asukiaaa/SideBBForRaspberryPi/plate/plate_for_raspi_pins.FCStd

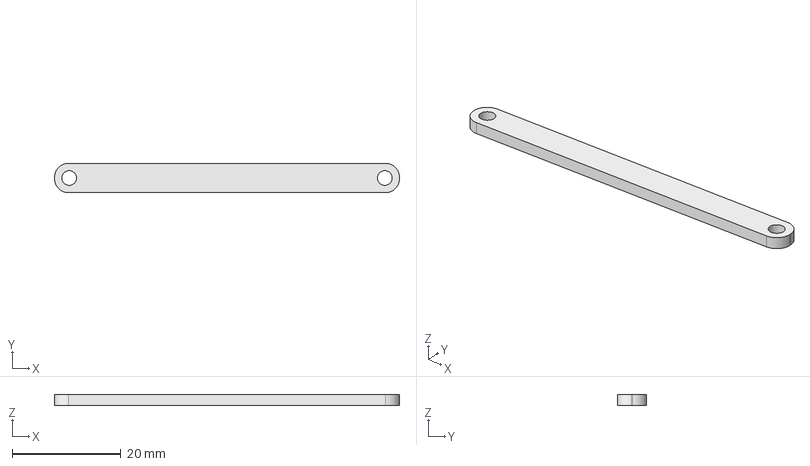
[picture p2: CAD file, 2023-03-24]
plate/plate_for_raspi_pins.FCStd
63.4 x 5.40 x 2.00 mm
