asukiaaa/SideBBForRaspberryPi/main_pcb/main_pcb.kicad_pcb

## KiCad design main_pcb/main_pcb.kicad_pcb (2020-06-21)

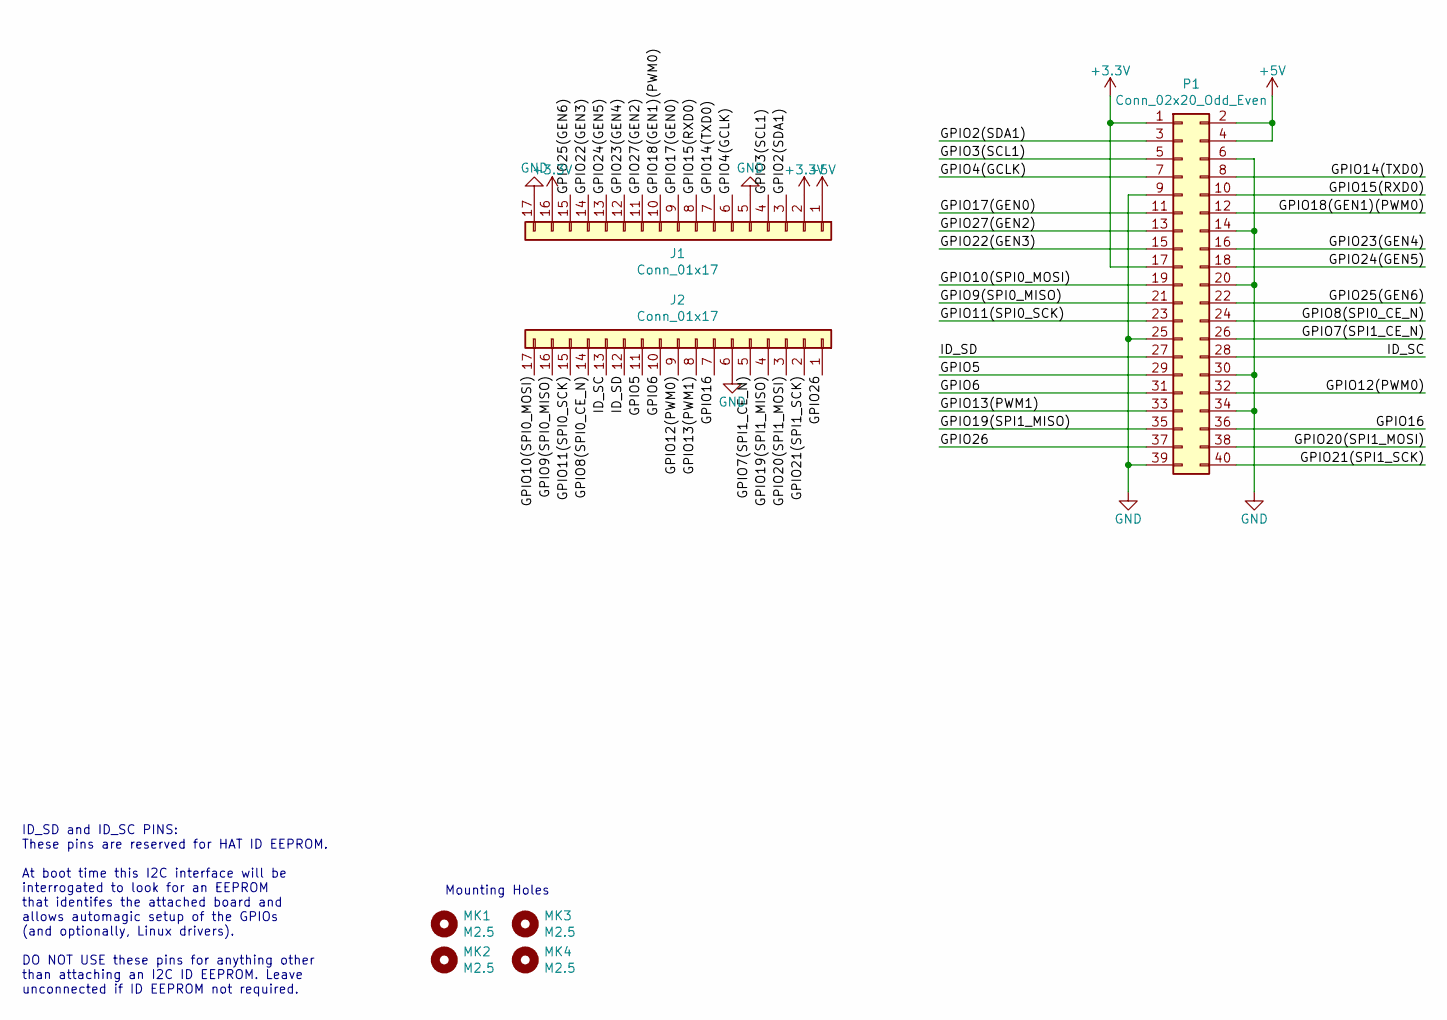
[picture p6: schematic main_pcb.sch]

Parts:
J1, J2: Conn_01x17; PinSocket_1x17_P2.54mm_Vertical
MK1, MK2, MK3, MK4: M2.5; MountingHole_2.7mm_M2.5
P1: Conn_02x20_Odd_Even; PinHeader_2x20_P2.54mm_Vertical

Connections:
+3V3: J1.2, J1.16, P1.1, P1.17
+5V: J1.1, P1.2, P1.4
/GPIO2(SDA1): J1.3, P1.3
/GPIO3(SCL1): J1.4, P1.5
/GPIO4(GCLK): J1.6, P1.7
/GPIO5: J2.11, P1.29
/GPIO6: J2.10, P1.31
/GPIO7(SPI1_CE_N): J2.5, P1.26
/GPIO8(SPI0_CE_N): J2.14, P1.24
/GPIO9(SPI0_MISO): J2.16, P1.21
/GPIO10(SPI0_MOSI): J2.17, P1.19
/GPIO11(SPI0_SCK): J2.15, P1.23
/GPIO12(PWM0): J2.9, P1.32
/GPIO13(PWM1): J2.8, P1.33
/GPIO14(TXD0): J1.7, P1.8
/GPIO15(RXD0): J1.8, P1.10
/GPIO16: J2.7, P1.36
/GPIO17(GEN0): J1.9, P1.11
/GPIO18(GEN1)(PWM0): J1.10, P1.12
/GPIO19(SPI1_MISO): J2.4, P1.35
/GPIO20(SPI1_MOSI): J2.3, P1.38
/GPIO21(SPI1_SCK): J2.2, P1.40
/GPIO22(GEN3): J1.14, P1.15
/GPIO23(GEN4): J1.12, P1.16
/GPIO24(GEN5): J1.13, P1.18
/GPIO25(GEN6): J1.15, P1.22
/GPIO26: J2.1, P1.37
/GPIO27(GEN2): J1.11, P1.13
/ID_SC: J2.13, P1.28
/ID_SD: J2.12, P1.27
GND: J1.5, J1.17, J2.6, P1.6, P1.9, P1.14, P1.20, P1.25, P1.30, P1.34, P1.39

Notes on the sheet:
ID_SD and ID_SC PINS: These pins are reserved for HAT ID EEPROM. At boot time this I2C interface will be interrogated to look for an EEPROM that identifes the attached board and allows automagic setup of the GPIOs (and optionally, Linux drivers). DO NOT USE these pins for anything other than attach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
Mounting Holes

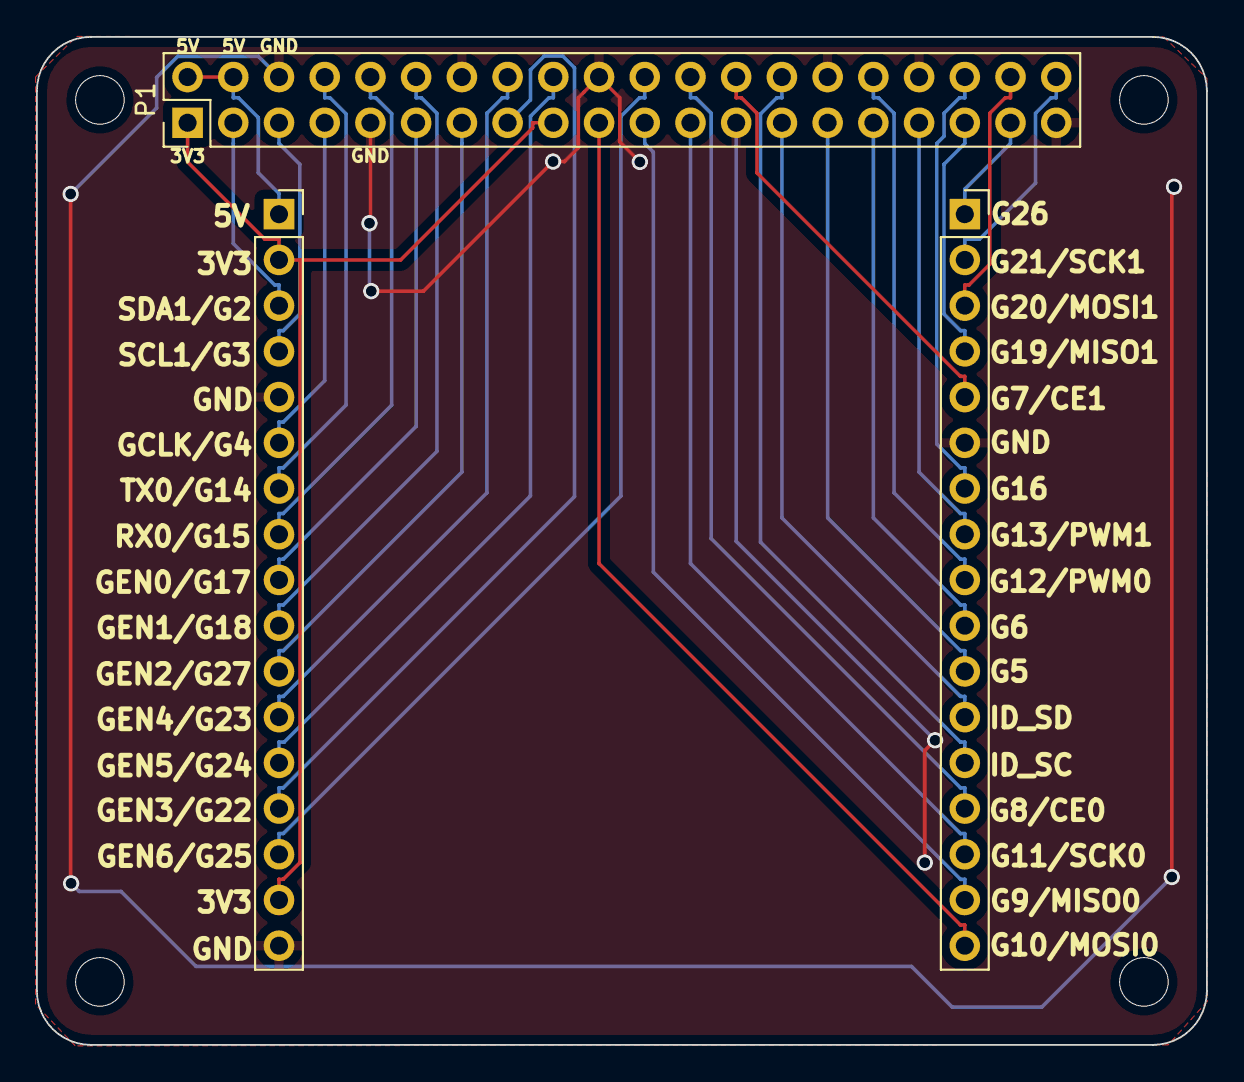
[picture p7: board main_pcb.kicad_pcb from above]

Board: 2 copper layers, 65.0 x 56.0 mm, 7 parts (0 on the bottom side), 31 nets.
