asukiaaa/SideBBForRaspberryPi/(commit log)

2019-12-13 Initial commit with draft joint pcb
    [joint_pcb.kicad_pcb, joint_pcb.sch]
2019-12-16 Add cupper and cut lines for joint pcb
    [joint_pcb.kicad_pcb]
2019-12-24 Add main_pcb
    [main_pcb.kicad_pcb, main_pcb.sch]
2019-12-25 Add text to joint pcb
    [joint_pcb.kicad_pcb]
2020-01-27 Correct hole position of main_pcb
    [main_pcb.kicad_pcb]
2020-01-30 Update position of pads on joint pcb
    [joint_pcb.kicad_pcb]
2020-01-30 Expand board width of joint_pcb
    [joint_pcb.kicad_pcb]
2020-01-30 Replace to pin socket from pin header on join pcb
    [joint_pcb.kicad_pcb, joint_pcb.sch]
2020-02-25 Add plate
    [plate_for_raspi_pins.FCStd]
2020-05-24 Apply header footprints to main pcb
    [main_pcb.kicad_pcb, main_pcb.sch]
2020-06-21 Remove mounting hole for pi on joint pcb
    [joint_pcb.kicad_pcb]
2020-06-21 Update something for main pcb
    [main_pcb.kicad_pcb]
2020-06-21 Change line position of outside on joint pcb
    [joint_pcb.kicad_pcb]
2020-08-20 Add r to edge and change spacer position
    [joint_pcb.kicad_pcb]
2020-08-20 Update revision to rev2020.08
    [joint_pcb.kicad_pcb]
2023-03-24 Update something
    [plate_for_raspi_pins.FCStd]
